Bzucak12/Maturitni_projekt/Ikony.docx

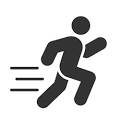
[picture p4: figure]
Stock vektor „Běžící ikony figur v různých stylech,“ (bez autorských poplatků) 2526632863 | Shutterstock
