Bzucak12/Maturitni_projekt/3D_model_krabicka/Model_krabicka.stl

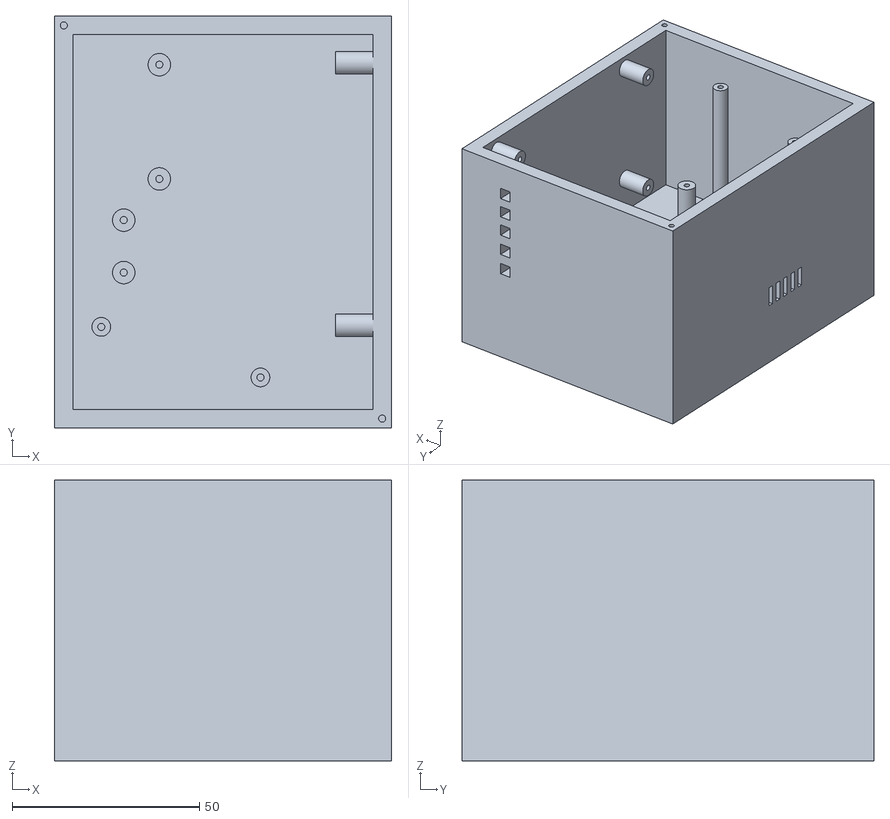
[picture p5: CAD file, 2026-03-26]
3D_model_krabicka/Model_krabicka.stl
90.0 x 110.0 x 75.0
