Bzucak12/Maturitni_projekt/3D_model_krabicka/Model_krabicka_viko.stl

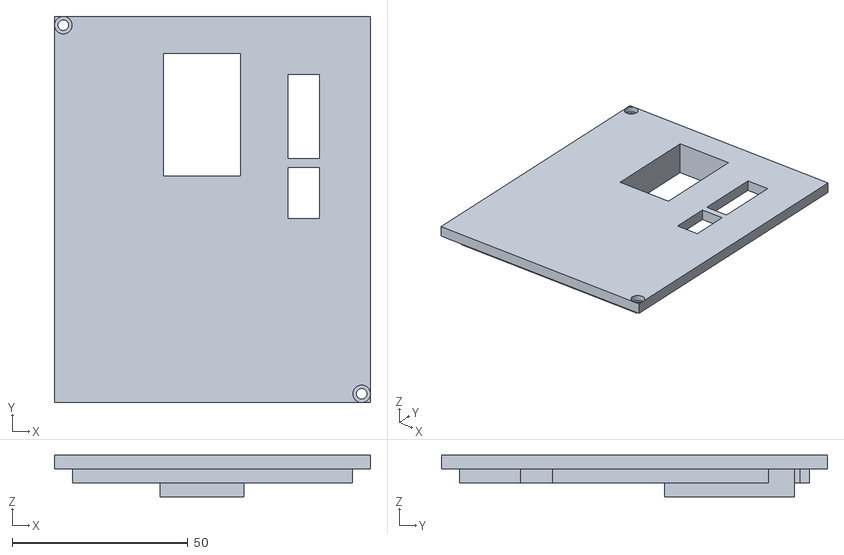
[picture p6: CAD file, 2026-03-26]
3D_model_krabicka/Model_krabicka_viko.stl
90.0 x 110.0 x 11.9
