Bzucak12/Maturitni_projekt/3D_model_krabicka/zaverecka-sensor_bme280.stl

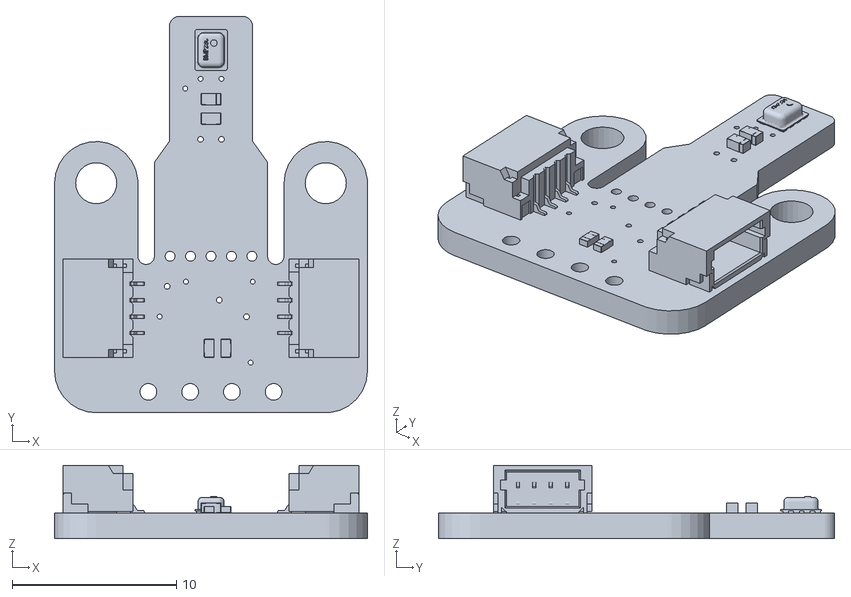
[picture p7: CAD file, 2026-01-28]
3D_model_krabicka/zaverecka-sensor_bme280.stl
19.1 x 24.1 x 4.47
