Bzucak12/Maturitni_projekt/3D_model_krabicka/OLED_1_3INCH_I2C.step

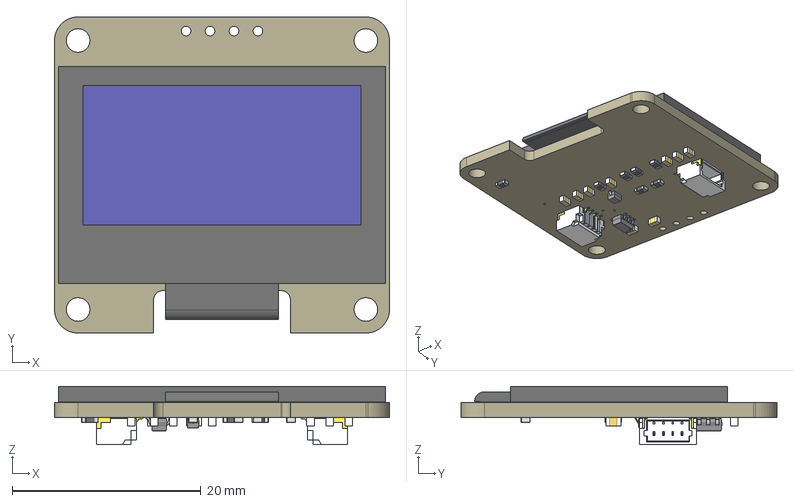
[picture p8: CAD file, 2026-01-28]
3D_model_krabicka/OLED_1_3INCH_I2C.step
35.5 x 33.5 x 6.19 mm
Board
LASKAKIT_HEART_4MM
LASKKIT_10MM_SILKSCREEN
PinsArrayL
PinsArrayR
FilletPinL
FilletPinR
USUP_4MM_SILKSCREEN x 2
1X04_1MM_RA x 2
2,5-PAD x 4
C0603 x 9
R0603 x 7
