Bzucak12/Maturitni_projekt/Kod_deska/kod_deska/include/cas.h

#pragma once

#include "knihovny.h"

void nastav_casove_pasmo(String casove_pasmo);
void incializace_casu(String casove_pasmo);
String ziskej_cas();
String ziskej_hodiny_minuty_sekundy();
String ziskej_den_mesic_rok();
