Bzucak12/Maturitni_projekt/Kod_deska/kod_deska/src/prace_s_ledkami.cpp

#include "prace_s_ledkami.h"

void aktualizaceLedek()
{
    if (teplota > horni_mez_teploty)
    {
        digitalWrite(LED_tep_vysoka, HIGH);
        digitalWrite(LED_tep_nizka, LOW);
    }
    else if (teplota < spodni_mez_teploty)
    {
        digitalWrite(LED_tep_vysoka, LOW);
        digitalWrite(LED_tep_nizka, HIGH);
    }
    else
    {
        digitalWrite(LED_tep_vysoka, LOW);
        digitalWrite(LED_tep_nizka, LOW);
    }

    if (vlhkost > horni_mez_vlhkosti)
    {
        digitalWrite(LED_vlhokost_vysoka, HIGH);
    }
    else
    {
        digitalWrite(LED_vlhokost_vysoka, LOW);
    }

    if (pohyb)
    {
        digitalWrite(LED_pohyb, HIGH);
    }
    else
    {
        digitalWrite(LED_pohyb, LOW);
    }

    if ((WiFi.status() == WL_CONNECTED))
    {
        digitalWrite(LED_wifi_pripojena, HIGH);
    }
    else
    {
        digitalWrite(LED_wifi_pripojena, LOW);
    }

}
